ndhuy1127/DA2-KIT-ATmega16/hardware/output/KIT-ATmega16-3d-top.png

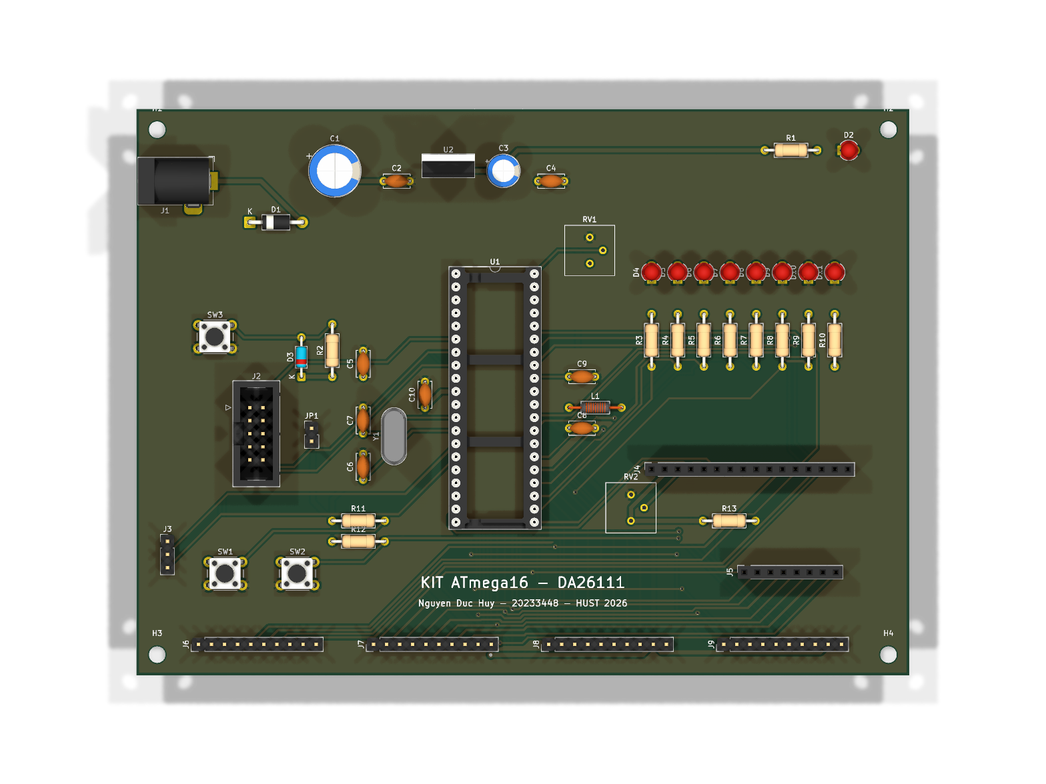
hardware/output/KIT-ATmega16-3d-top.png
