ndhuy1127/DA2-KIT-ATmega16/hardware/output/bom.csv

Reference | Value | Footprint | QUANTITY
C1 | 470uF/25V | Capacitor_THT:CP_Radial_D10.0mm_P5.00mm | 1
C2,C4,C5,C8-C10 | 100nF | Capacitor_THT:C_Disc_D5.0mm_W2.5mm_P5.00mm | 6
C3 | 100uF/16V | Capacitor_THT:CP_Radial_D6.3mm_P2.50mm | 1
C6,C7 | 22pF | Capacitor_THT:C_Disc_D5.0mm_W2.5mm_P5.00mm | 2
D1 | 1N4007 | Diode_THT:D_DO-41_SOD81_P10.16mm_Horizontal | 1
D2 | Xanh | LED_THT:LED_D3.0mm | 1
D3 | 1N4148 | Diode_THT:D_DO-35_SOD27_P7.62mm_Horizontal | 1
D4-D11 | Đỏ | LED_THT:LED_D3.0mm | 8
J1 | DC 9-12V | Connector_BarrelJack:BarrelJack_Horizontal | 1
J2 | ISP (USBasp) | Connector_IDC:IDC-Header_2x05_P2.54mm_Vertical | 1
J3 | USB-UART | Connector_PinHeader_2.54mm:PinHeader_1x03_P2.54mm_Vertical | 1
J4 | LCD1602 | Connector_PinSocket_2.54mm:PinSocket_1x16_P2.54mm_Vertical | 1
J5 | Keypad 4x4 | Connector_PinSocket_2.54mm:PinSocket_1x08_P2.54mm_Vertical | 1
J6 | PORTA | Connector_PinHeader_2.54mm:PinHeader_1x10_P2.54mm_Vertical | 1
J7 | PORTB | Connector_PinHeader_2.54mm:PinHeader_1x10_P2.54mm_Vertical | 1
J8 | PORTC | Connector_PinHeader_2.54mm:PinHeader_1x10_P2.54mm_Vertical | 1
J9 | PORTD | Connector_PinHeader_2.54mm:PinHeader_1x10_P2.54mm_Vertical | 1
JP1 | Cấp 5V từ ISP | Connector_PinHeader_2.54mm:PinHeader_1x02_P2.54mm_Vertical | 1
L1 | 10uH | Inductor_THT:L_Axial_L5.3mm_D2.2mm_P10.16mm_Horizontal_Vishay_IM-1 | 1
R1 | 1k | Resistor_THT:R_Axial_DIN0207_L6.3mm_D2.5mm_P10.16mm_Horizontal | 1
R2,R11,R12 | 10k | Resistor_THT:R_Axial_DIN0207_L6.3mm_D2.5mm_P10.16mm_Horizontal | 3
R3-R10 | 330 | Resistor_THT:R_Axial_DIN0207_L6.3mm_D2.5mm_P10.16mm_Horizontal | 8
R13 | 33 | Resistor_THT:R_Axial_DIN0207_L6.3mm_D2.5mm_P10.16mm_Horizontal | 1
RV1,RV2 | 10k | Potentiometer_THT:Potentiometer_Bourns_3386P_Vertical | 2
SW1 | SW1 (INT0) | Button_Switch_THT:SW_PUSH_6mm | 1
SW2 | SW2 (INT1) | Button_Switch_THT:SW_PUSH_6mm | 1
SW3 | RESET | Button_Switch_THT:SW_PUSH_6mm | 1
U1 | ATmega16A-PU | Package_DIP:DIP-40_W15.24mm_Socket | 1
U2 | LM7805 | Package_TO_SOT_THT:TO-220-3_Vertical | 1
Y1 | 8MHz | Crystal:Crystal_HC49-U_Vertical | 1
