ndhuy1127/DA2-KIT-ATmega16/hardware/output/KIT-ATmega16-schematic.pdf

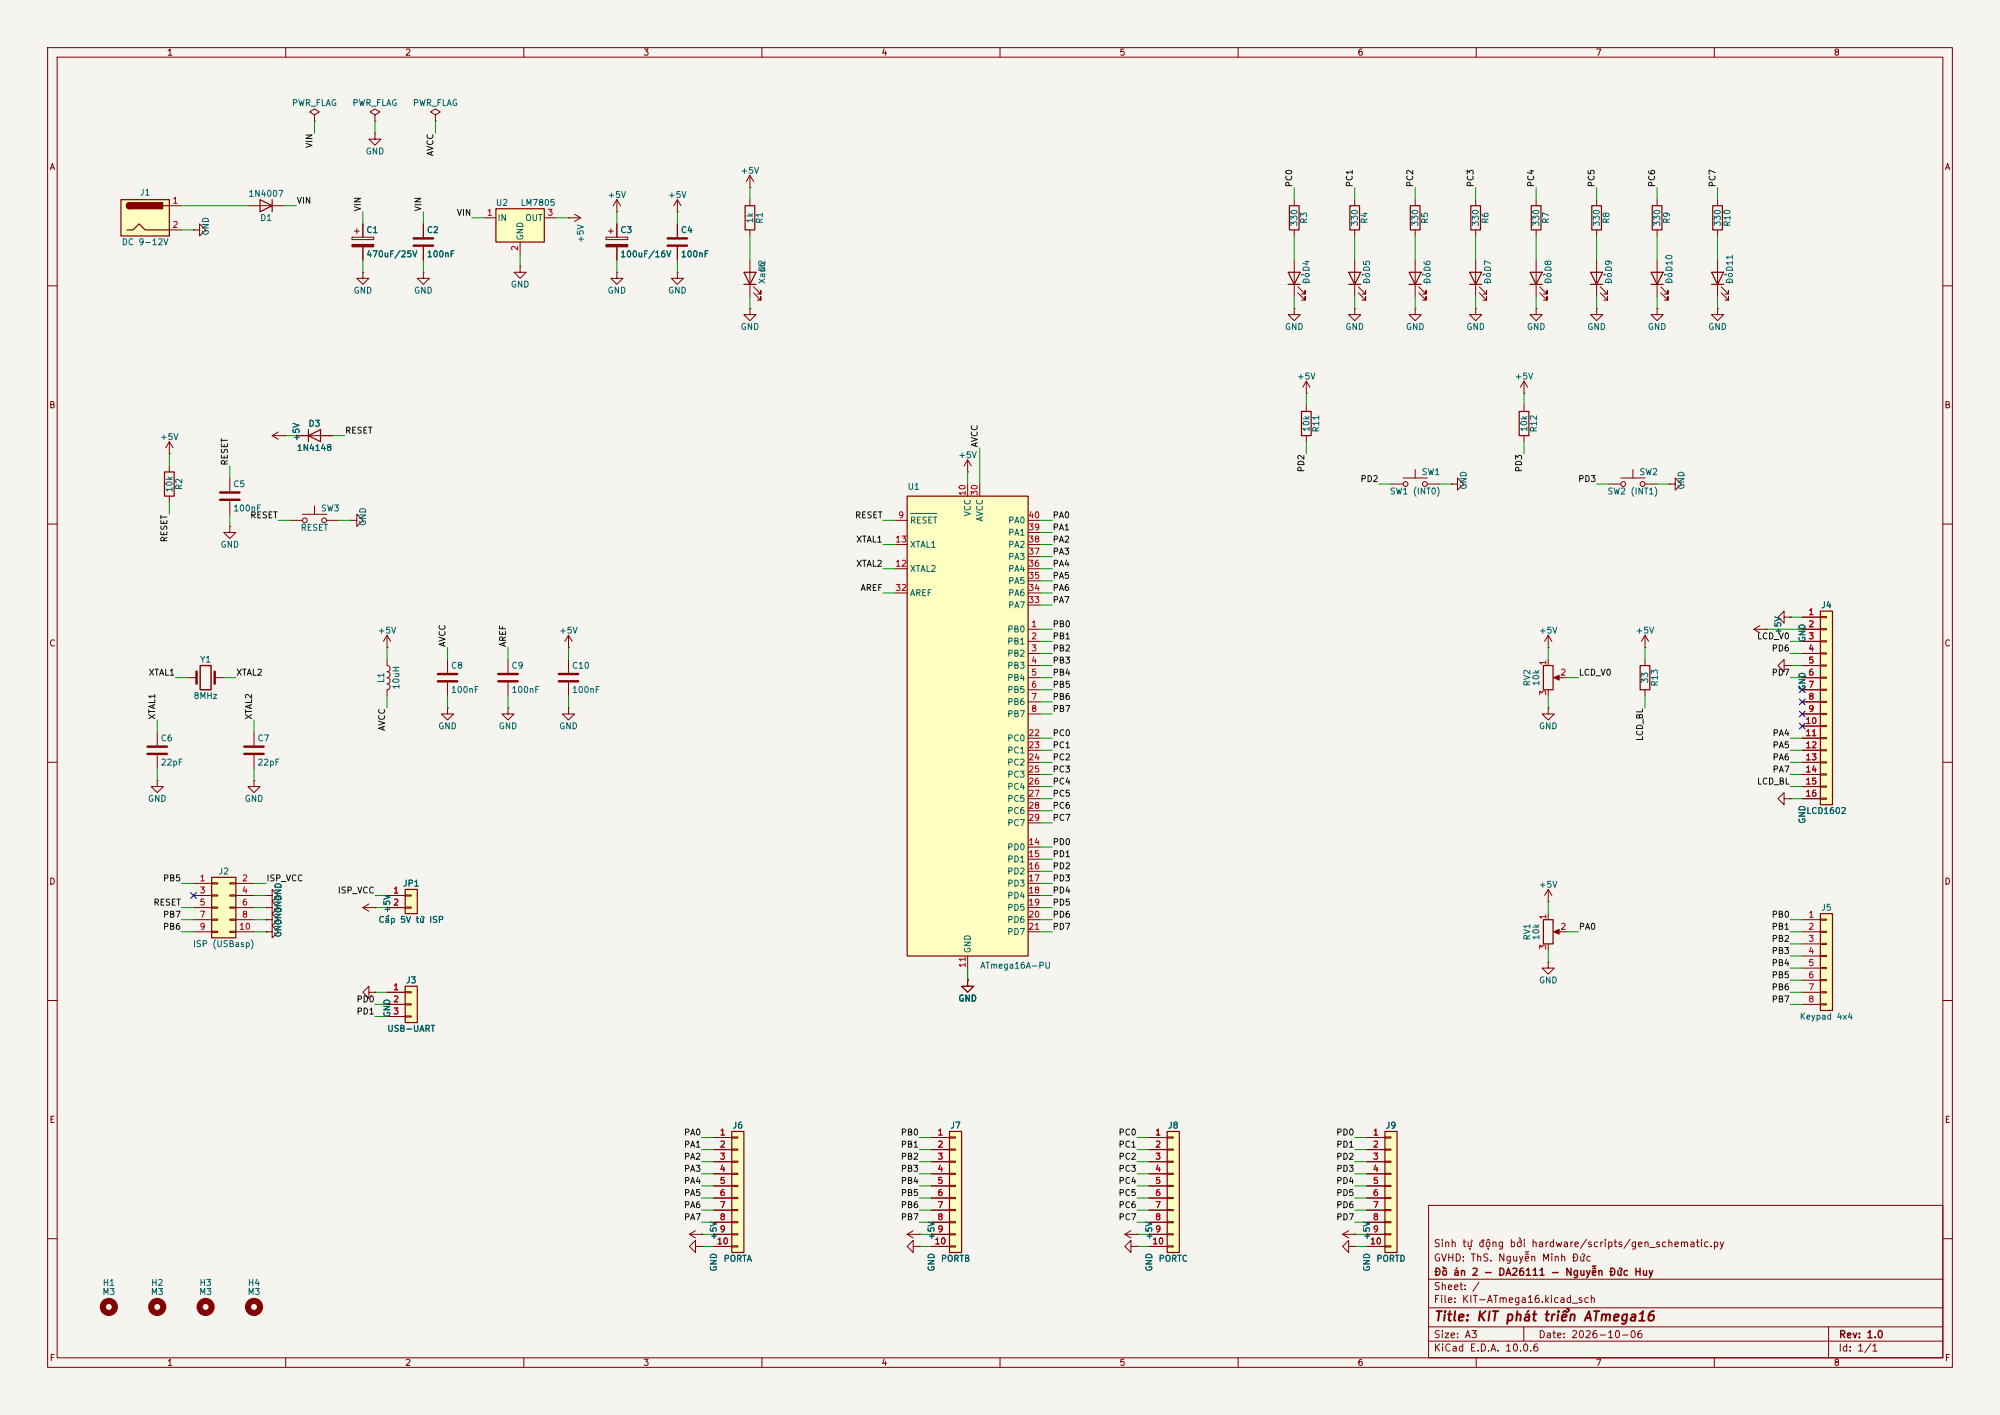
[picture p4: page 1]

GVHD: ThS. Nguyễn Minh Đức
Đồ án 2 - DA26111 - Nguyễn Đức Huy
Sheet: /
File: KIT-ATmega16.kicad_sch
Title: KIT phát triển ATmega16

Size: A3 | Rev: 1.0 | F Date: 2026-10-06
KiCad E.D.A. 10.0.6 | Id: 1/1
