ndhuy1127/DA2-KIT-ATmega16/hardware/output/KIT-ATmega16-B_Cu.pdf

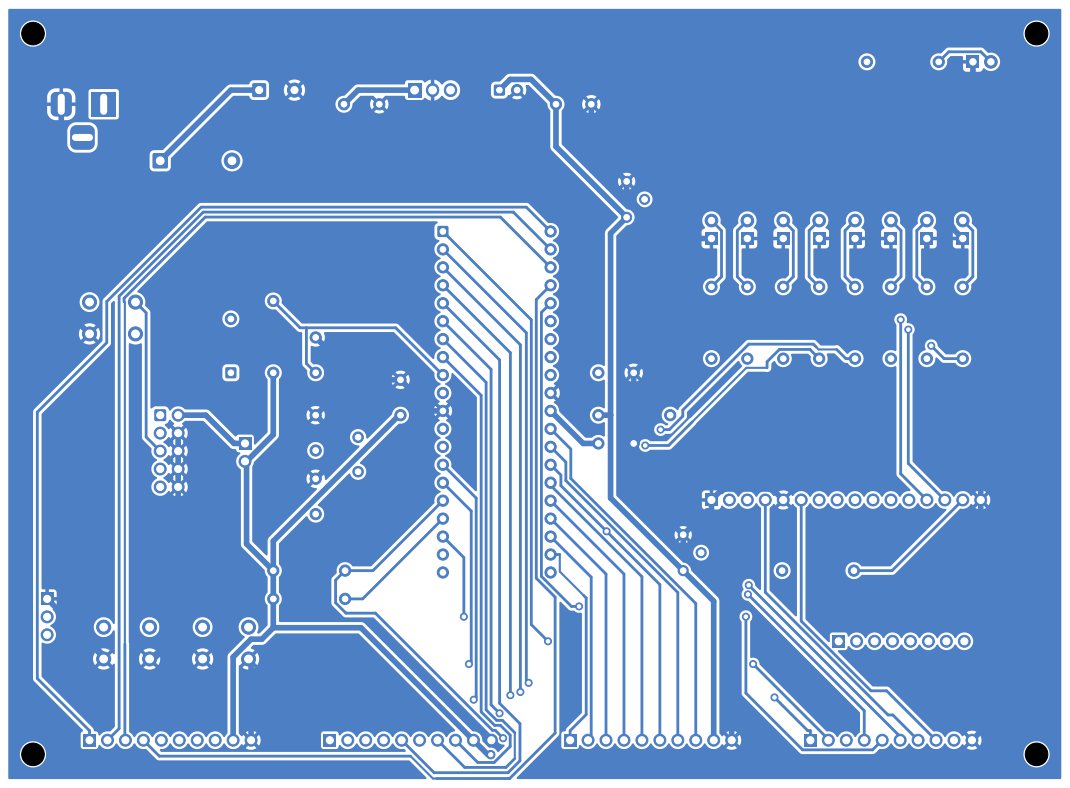
[picture p5: page 1]
