ndhuy1127/DA2-KIT-ATmega16/hardware/output/KIT-ATmega16-Edge_Cuts.pdf

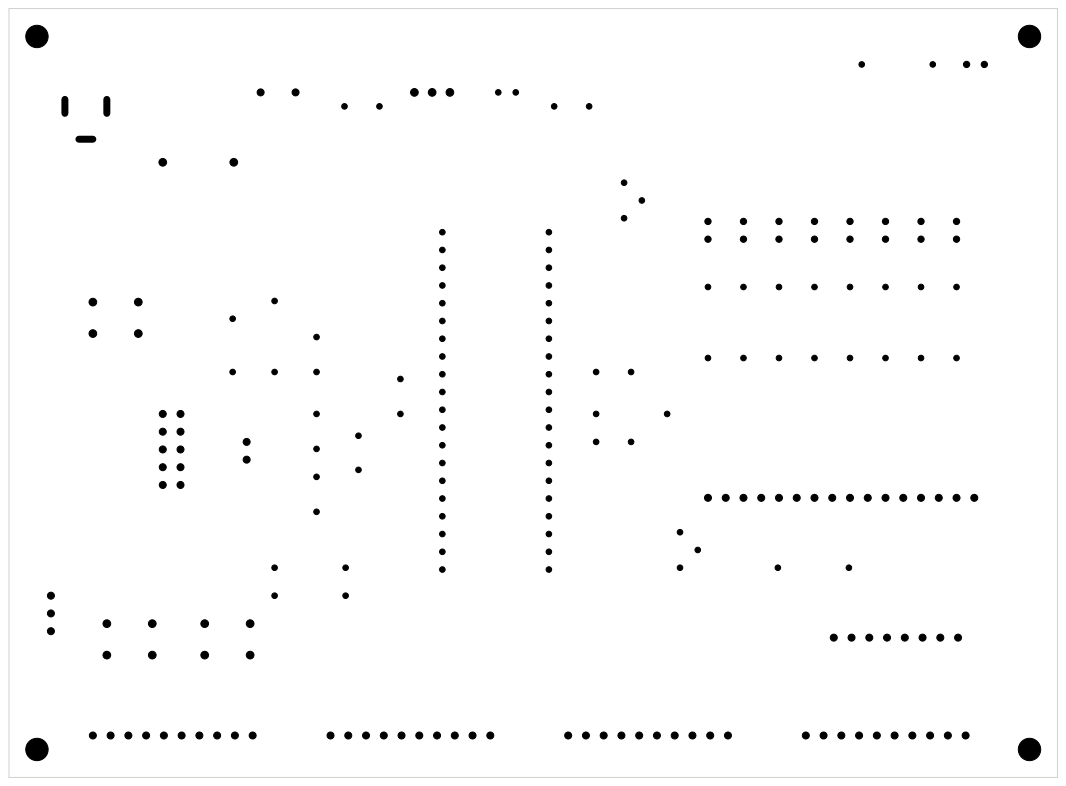
[picture p6: page 1]
