ndhuy1127/DA2-KIT-ATmega16/hardware/output/KIT-ATmega16-F_Cu.pdf

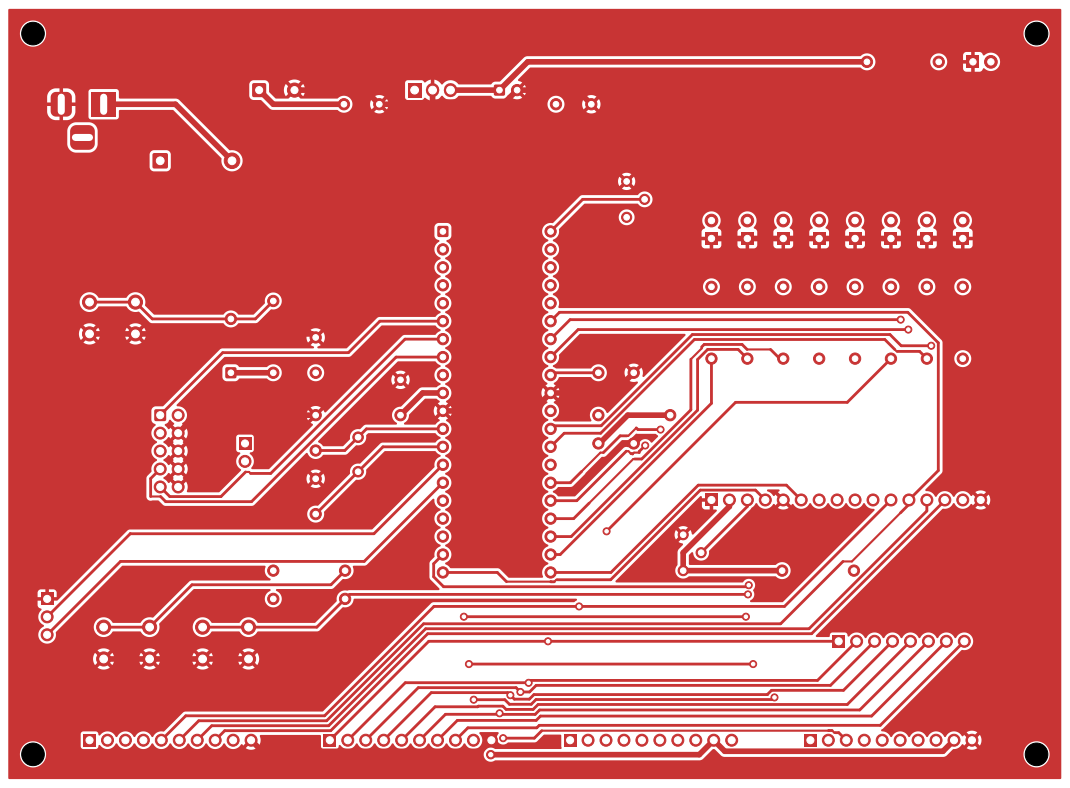
[picture p7: page 1]
