ndhuy1127/DA2-KIT-ATmega16/hardware/output/KIT-ATmega16-F_Silkscreen.pdf

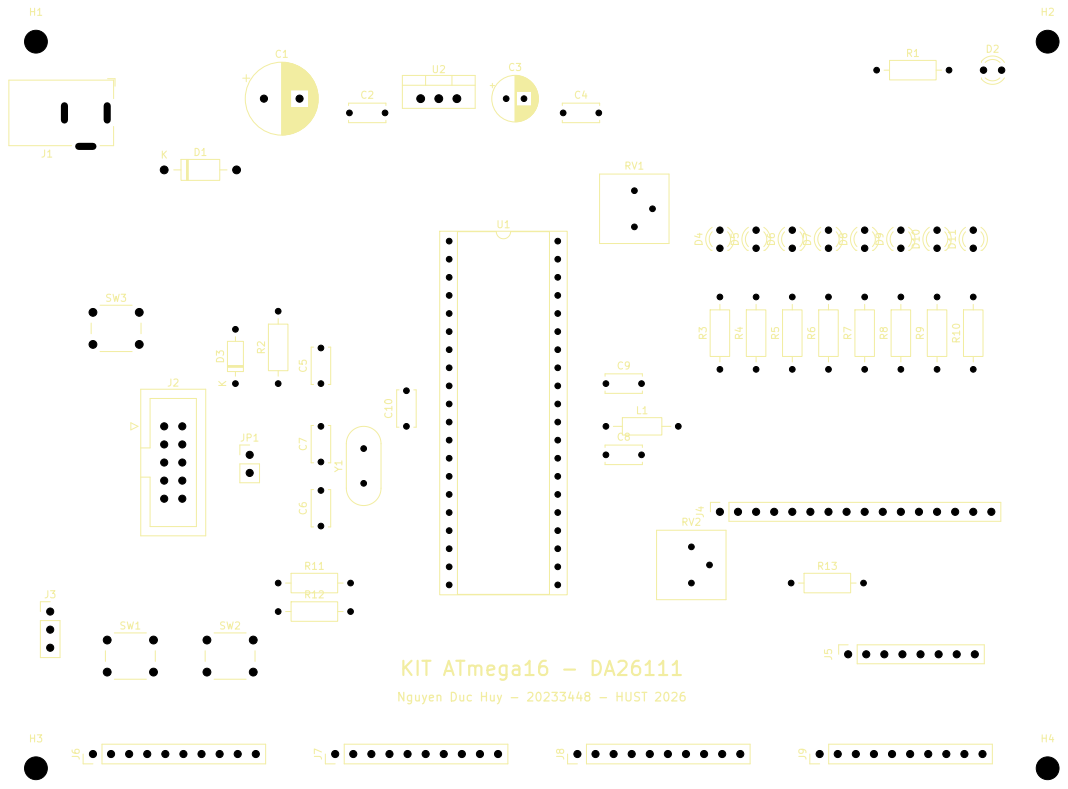
[picture p8: page 1]
