ndhuy1127/DA2-KIT-ATmega16/hardware/kicad/KIT-ATmega16.kicad_pcb

## KiCad design hardware/kicad/KIT-ATmega16.kicad_pcb (2026-10-15)

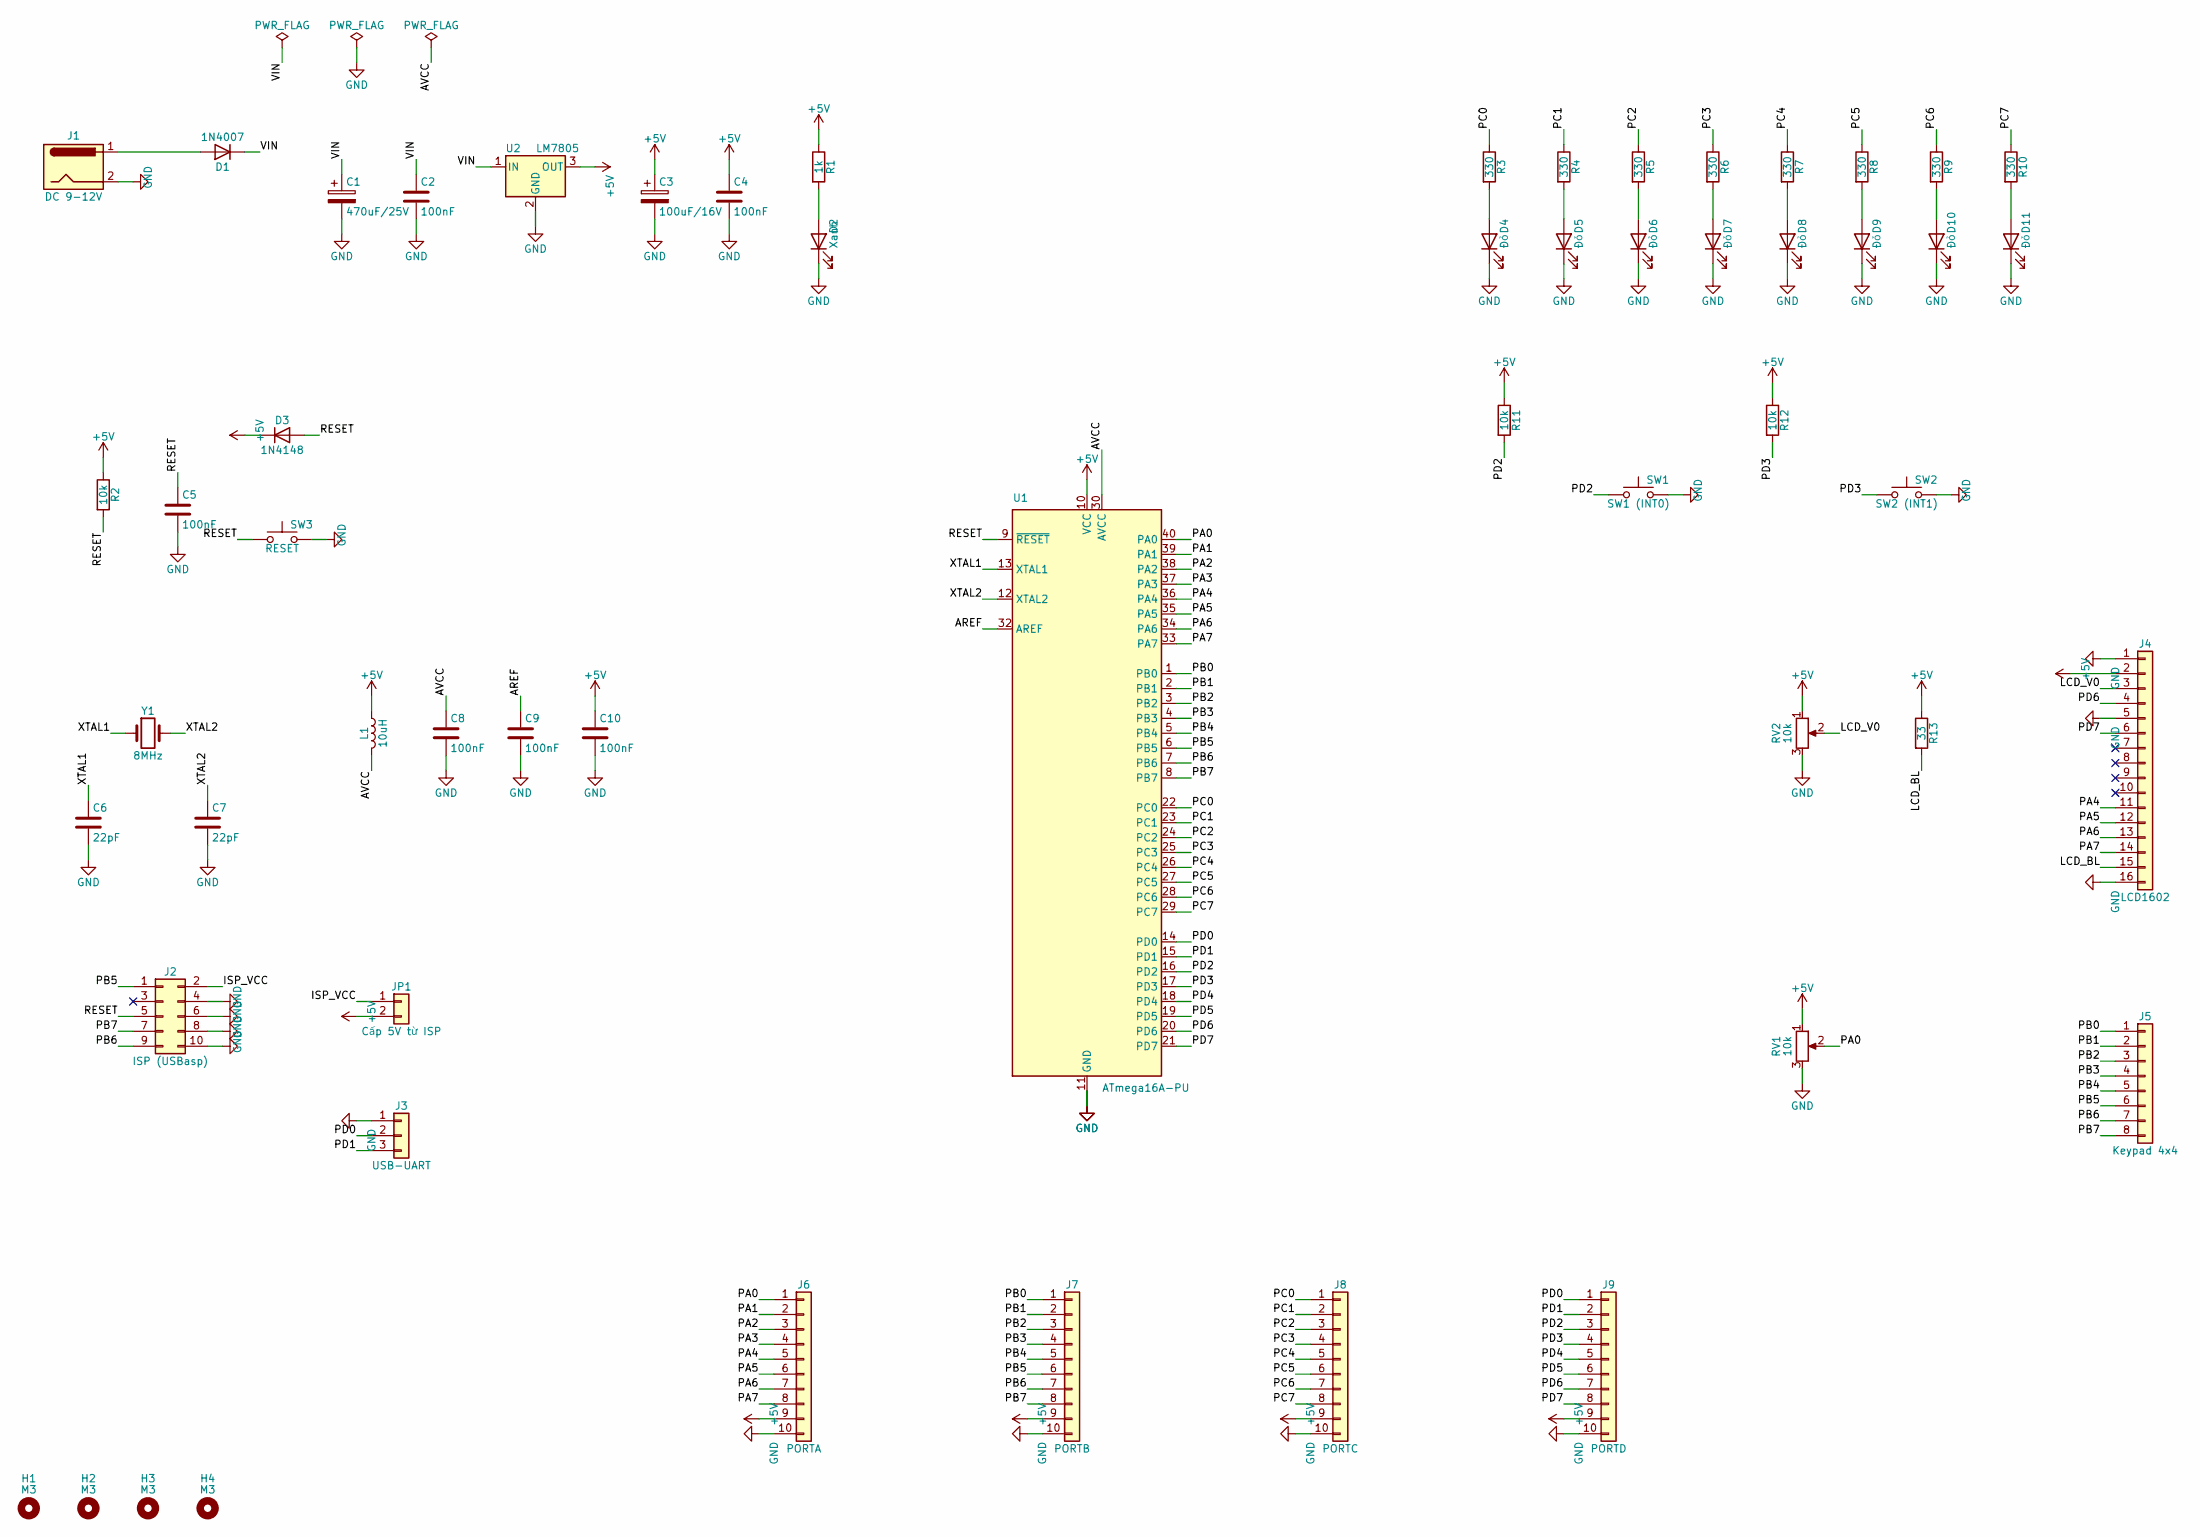
[picture p9: schematic KIT-ATmega16.kicad_sch, KIT phát triển ATmega16]

Parts:
C1: 470uF/25V; CP_Radial_D10.0mm_P5.00mm
C2, C4, C5, C8, C9, C10: 100nF; C_Disc_D5.0mm_W2.5mm_P5.00mm
C3: 100uF/16V; CP_Radial_D6.3mm_P2.50mm
C6, C7: 22pF; C_Disc_D5.0mm_W2.5mm_P5.00mm
D1: 1N4007; D_DO-41_SOD81_P10.16mm_Horizontal
D2: Xanh; LED_D3.0mm
D3: 1N4148; D_DO-35_SOD27_P7.62mm_Horizontal
D4, D5, D6, D7, D8, D9, D10, D11: Đỏ; LED_D3.0mm
H1, H2, H3, H4: M3; MountingHole_3.2mm_M3
J1: DC 9-12V; BarrelJack_Horizontal
J2: ISP (USBasp); IDC-Header_2x05_P2.54mm_Vertical
J3: USB-UART; PinHeader_1x03_P2.54mm_Vertical
J4: LCD1602; PinSocket_1x16_P2.54mm_Vertical
J5: Keypad 4x4; PinSocket_1x08_P2.54mm_Vertical
J6: PORTA; PinHeader_1x10_P2.54mm_Vertical
J7: PORTB; PinHeader_1x10_P2.54mm_Vertical
J8: PORTC; PinHeader_1x10_P2.54mm_Vertical
J9: PORTD; PinHeader_1x10_P2.54mm_Vertical
JP1: Cấp 5V từ ISP; PinHeader_1x02_P2.54mm_Vertical
L1: 10uH; L_Axial_L5.3mm_D2.2mm_P10.16mm_Horizontal_Vishay_IM-1
R1: 1k; R_Axial_DIN0207_L6.3mm_D2.5mm_P10.16mm_Horizontal
R2, R11, R12: 10k; R_Axial_DIN0207_L6.3mm_D2.5mm_P10.16mm_Horizontal
R3, R4, R5, R6, R7, R8, R9, R10: 330; R_Axial_DIN0207_L6.3mm_D2.5mm_P10.16mm_Horizontal
R13: 33; R_Axial_DIN0207_L6.3mm_D2.5mm_P10.16mm_Horizontal
RV1, RV2: 10k; Potentiometer_Bourns_3386P_Vertical
SW1: SW1 (INT0); SW_PUSH_6mm
SW2: SW2 (INT1); SW_PUSH_6mm
SW3: RESET; SW_PUSH_6mm
U1: ATmega16A-PU; DIP-40_W15.24mm_Socket
U2: LM7805; TO-220-3_Vertical
Y1: 8MHz; Crystal_HC49-U_Vertical

Connections:
+5V: C3.1, C4.1, C10.1, D3.1 (K), J4.2, J6.9, J7.9, J8.9, J9.9, JP1.2, L1.1, R1.1, R2.1, R11.1, R12.1, R13.1, RV1.1, RV2.1, U1.10 (VCC), U2.3 (OUT)
/AREF: C9.1, U1.32 (AREF)
/AVCC: C8.1, L1.2, U1.30 (AVCC)
/ISP_VCC: J2.2, JP1.1
/LCD_BL: J4.15, R13.2
/LCD_V0: J4.3, RV2.2
/PA0: J6.1, RV1.2, U1.40 (PA0)
/PA1: J6.2, U1.39 (PA1)
/PA2: J6.3, U1.38 (PA2)
/PA3: J6.4, U1.37 (PA3)
/PA4: J4.11, J6.5, U1.36 (PA4)
/PA5: J4.12, J6.6, U1.35 (PA5)
/PA6: J4.13, J6.7, U1.34 (PA6)
/PA7: J4.14, J6.8, U1.33 (PA7)
/PB0: J5.1, J7.1, U1.1 (PB0)
/PB1: J5.2, J7.2, U1.2 (PB1)
/PB2: J5.3, J7.3, U1.3 (PB2)
/PB3: J5.4, J7.4, U1.4 (PB3)
/PB4: J5.5, J7.5, U1.5 (PB4)
/PB5: J2.1, J5.6, J7.6, U1.6 (PB5)
/PB6: J2.9, J5.7, J7.7, U1.7 (PB6)
/PB7: J2.7, J5.8, J7.8, U1.8 (PB7)
/PC0: J8.1, R3.1, U1.22 (PC0)
/PC1: J8.2, R4.1, U1.23 (PC1)
/PC2: J8.3, R5.1, U1.24 (PC2)
/PC3: J8.4, R6.1, U1.25 (PC3)
/PC4: J8.5, R7.1, U1.26 (PC4)
/PC5: J8.6, R8.1, U1.27 (PC5)
/PC6: J8.7, R9.1, U1.28 (PC6)
/PC7: J8.8, R10.1, U1.29 (PC7)
/PD0: J3.2, J9.1, U1.14 (PD0)
/PD1: J3.3, J9.2, U1.15 (PD1)
/PD2: J9.3, R11.2, SW1.1, U1.16 (PD2)
/PD3: J9.4, R12.2, SW2.1, U1.17 (PD3)
/PD4: J9.5, U1.18 (PD4)
/PD5: J9.6, U1.19 (PD5)
/PD6: J4.4, J9.7, U1.20 (PD6)
/PD7: J4.6, J9.8, U1.21 (PD7)
/RESET: C5.1, D3.2 (A), J2.5, R2.2, SW3.1, U1.9 (~RESET)
/VIN: C1.1, C2.1, D1.1 (K), U2.1 (IN)
/XTAL1: C6.1, U1.13 (XTAL1), Y1.1
/XTAL2: C7.1, U1.12 (XTAL2), Y1.2
GND: C1.2, C2.2, C3.2, C4.2, C5.2, C6.2, C7.2, C8.2, C9.2, C10.2, D2.1 (K), D4.1 (K), D5.1 (K), D6.1 (K), D7.1 (K), D8.1 (K), D9.1 (K), D10.1 (K), D11.1 (K), J1.2, J2.4, J2.6, J2.8, J2.10, J3.1, J4.1, J4.5, J4.16, J6.10, J7.10, J8.10, J9.10, RV1.3, RV2.3, SW1.2, SW2.2, SW3.2, U1.11 (GND), U1.31 (GND), U2.2 (GND)
unnamed: D1.2 (A), J1.1
unnamed: D2.2 (A), R1.2
unnamed: D4.2 (A), R3.2
unnamed: D5.2 (A), R4.2
unnamed: D6.2 (A), R5.2
unnamed: D7.2 (A), R6.2
unnamed: D8.2 (A), R7.2
unnamed: D9.2 (A), R8.2
unnamed: D10.2 (A), R9.2
unnamed: D11.2 (A), R10.2

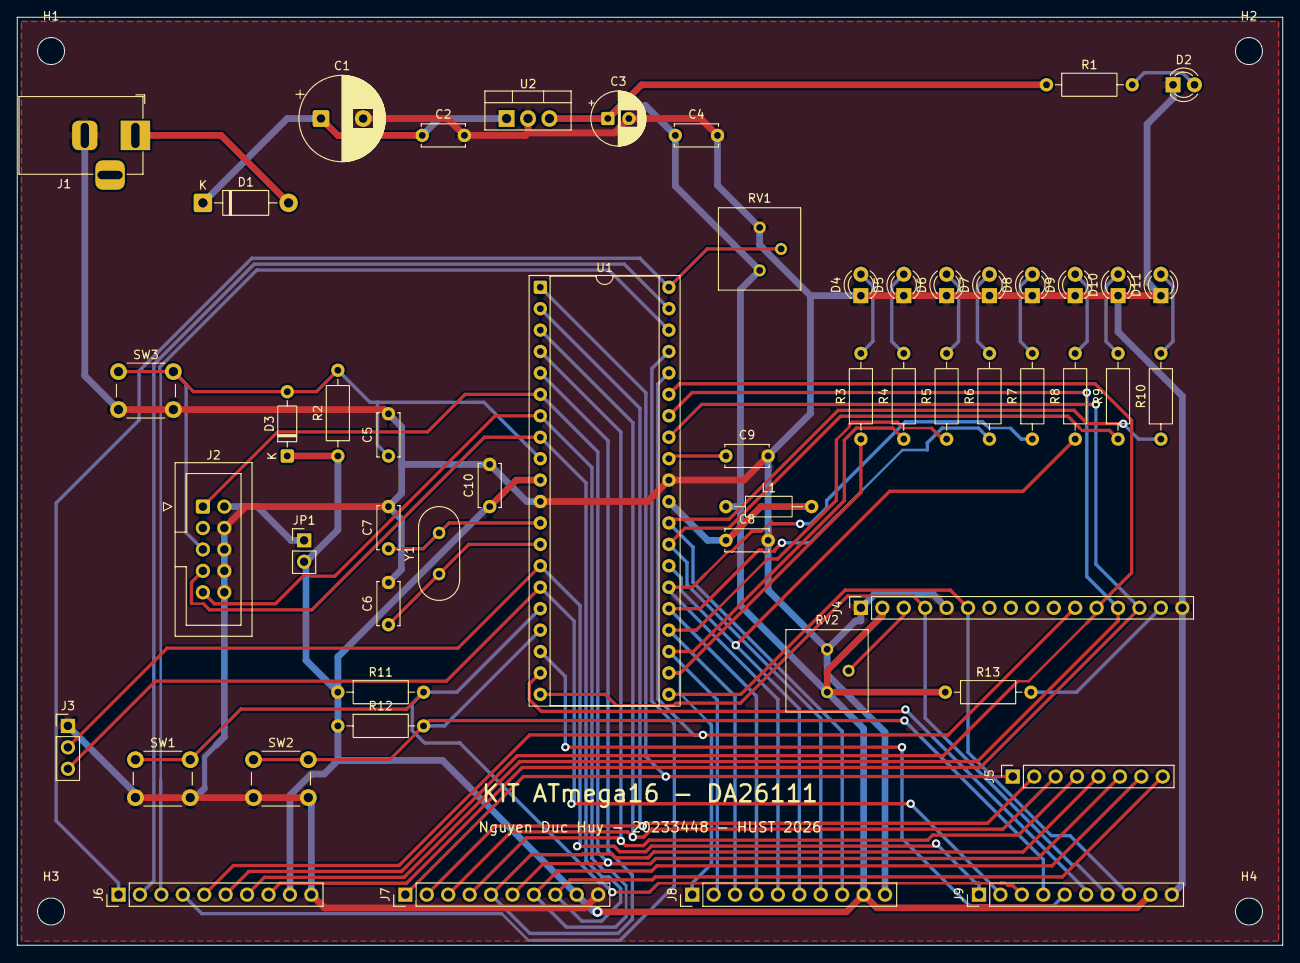
[picture p10: board KIT-ATmega16.kicad_pcb from above]

Board: 2 copper layers, 150.0 x 110.0 mm, 57 parts (0 on the bottom side), 53 nets.
