ndhuy1127/DA2-KIT-ATmega16/(commit log)

2026-10-15 Tuần 1: yêu cầu, sơ đồ khối, tài liệu tham khảo
2026-10-15 Tuần 2: bảng phân chân, fuse và BOM
2026-10-15 Tuần 3: schematic KiCad, ERC 0 lỗi, kiểm tra netlist
    [KIT-ATmega16.kicad_sch, bom.csv]
2026-10-15 Tuần 4: PCB 2 lớp, DRC 0 lỗi, Gerber, ảnh 3D
    [KIT-ATmega16-B_Cu.gbl, KIT-ATmega16-B_Mask.gbs, KIT-ATmega16-B_Silkscreen.gbo, KIT-ATmega16-Edge_Cuts.gm1, KIT-ATmega16-F_Cu.gtl, KIT-ATmega16-F_Mask.gts, KIT-ATmega16-F_Silkscreen.gto, KIT-ATmega16-NPTH.drl]
2026-10-15 Tuần 5: kế hoạch điều chỉnh, firmware GPIO/nút/ngắt/Timer, hướng dẫn mô phỏng
2026-10-15 Viết lại tài liệu cho tự nhiên, bỏ phần SimulIDE
2026-10-15 Thêm báo cáo tuần 1, bỏ file docx
